tjeffree/lumberelite/README.md

# lumberelite

Based off of the brilliant work of [Peej's Lumberjack](https://github.com/peej/lumberjack-keyboard).

An Elite-C version of the Lumberjack with the addition of an OLED screen.

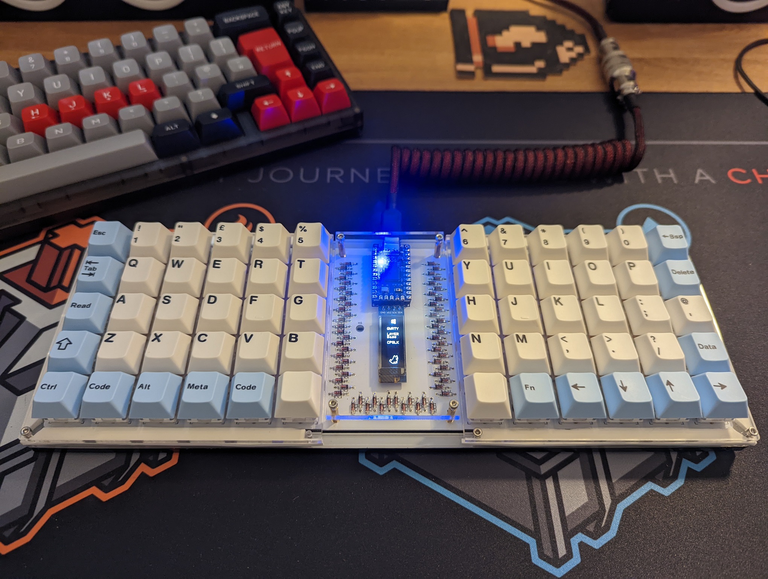
[picture p1: images/le_1.jpg]

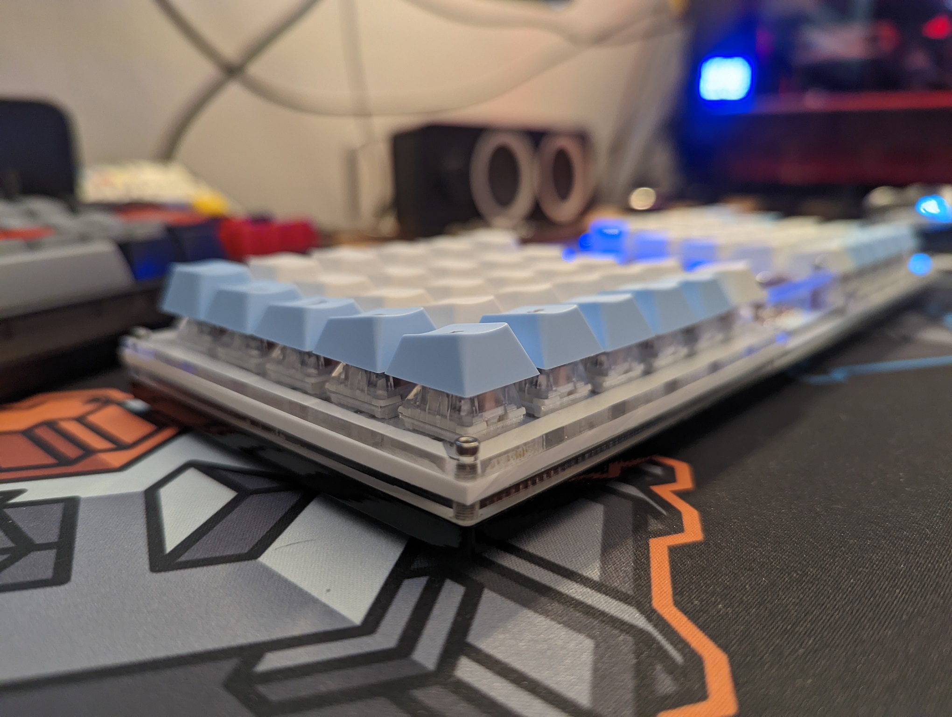
[picture p2: images/le_2.jpg]

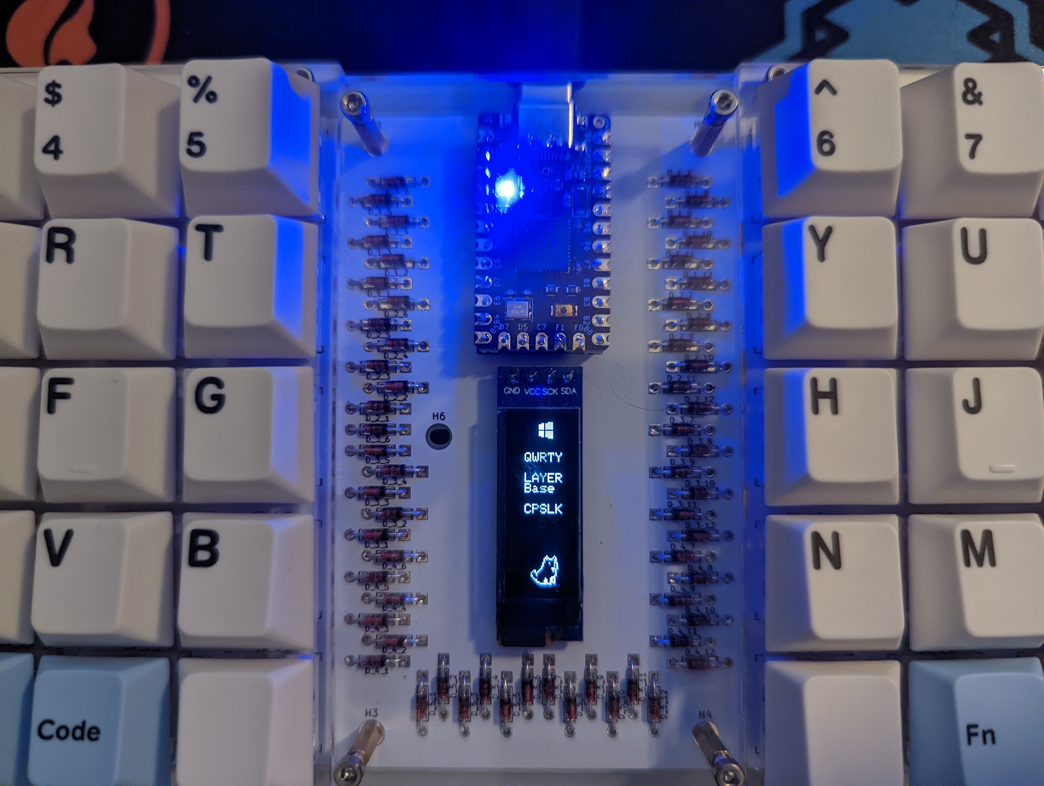
[picture p3: images/le_3.jpg]

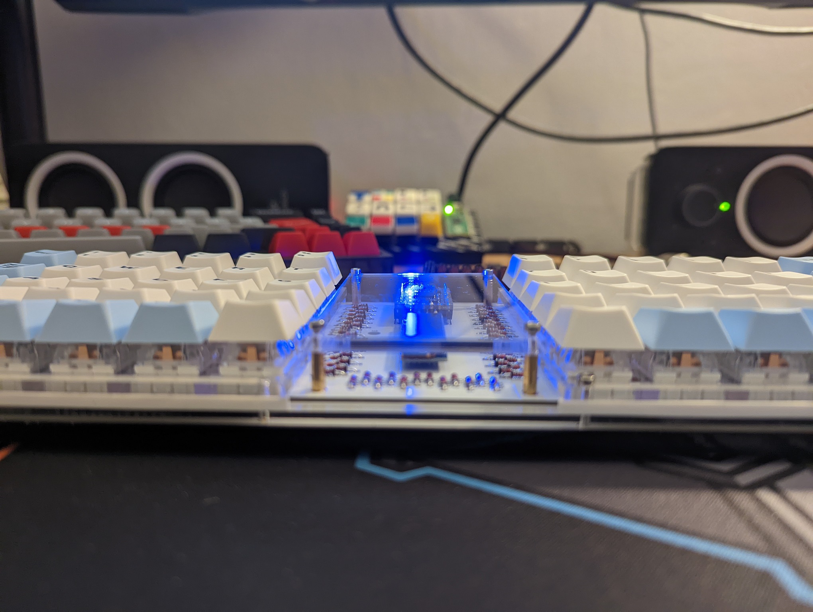
[picture p4: images/le_4.jpg]
