tjeffree/lumberelite/dxf/lumberjack-split v18 - Bottom.dxf

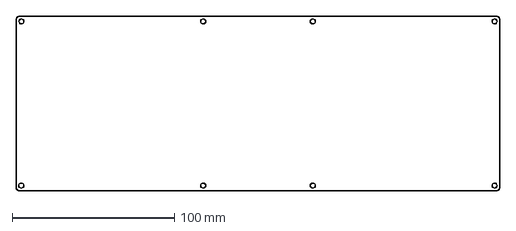
[picture p5: CAD file, 2022-02-27]
dxf/lumberjack-split v18 - Bottom.dxf
297.8 x 107.4 mm
