tjeffree/lumberelite/dxf/lumberjack-split v18 - Center.dxf

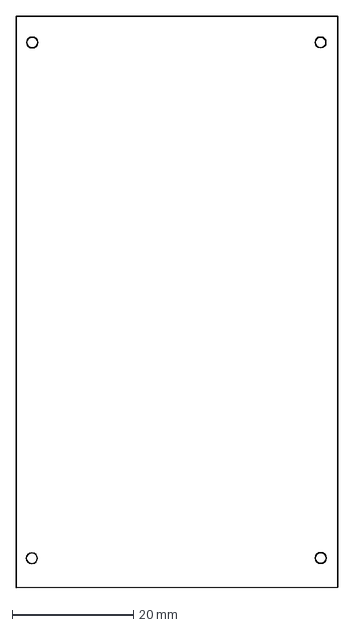
[picture p6: CAD file, 2022-02-27]
dxf/lumberjack-split v18 - Center.dxf
53.1 x 94.3 mm
