tjeffree/lumberelite/dxf/lumberjack-split v18 - Mid.dxf

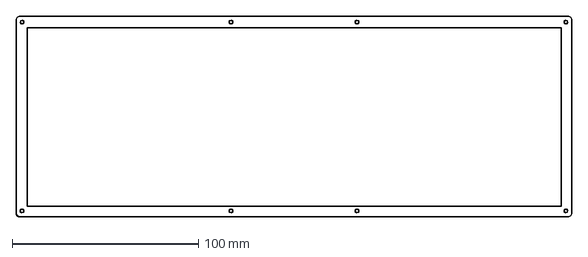
[picture p7: CAD file, 2022-02-27]
dxf/lumberjack-split v18 - Mid.dxf
297.8 x 107.4 mm
