tjeffree/lumberelite/dxf/lumberjack-split v18 - Top.dxf

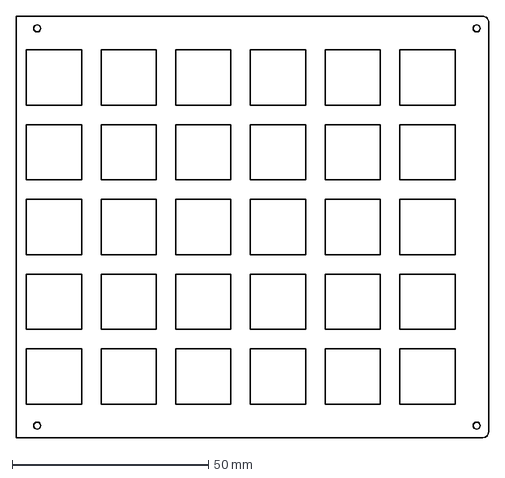
[picture p8: CAD file, 2022-02-27]
dxf/lumberjack-split v18 - Top.dxf
120.5 x 107.4 mm
