tjeffree/lumberelite/lumberelite.kicad_pcb

## KiCad design lumberelite.kicad_pcb (2022-02-27)

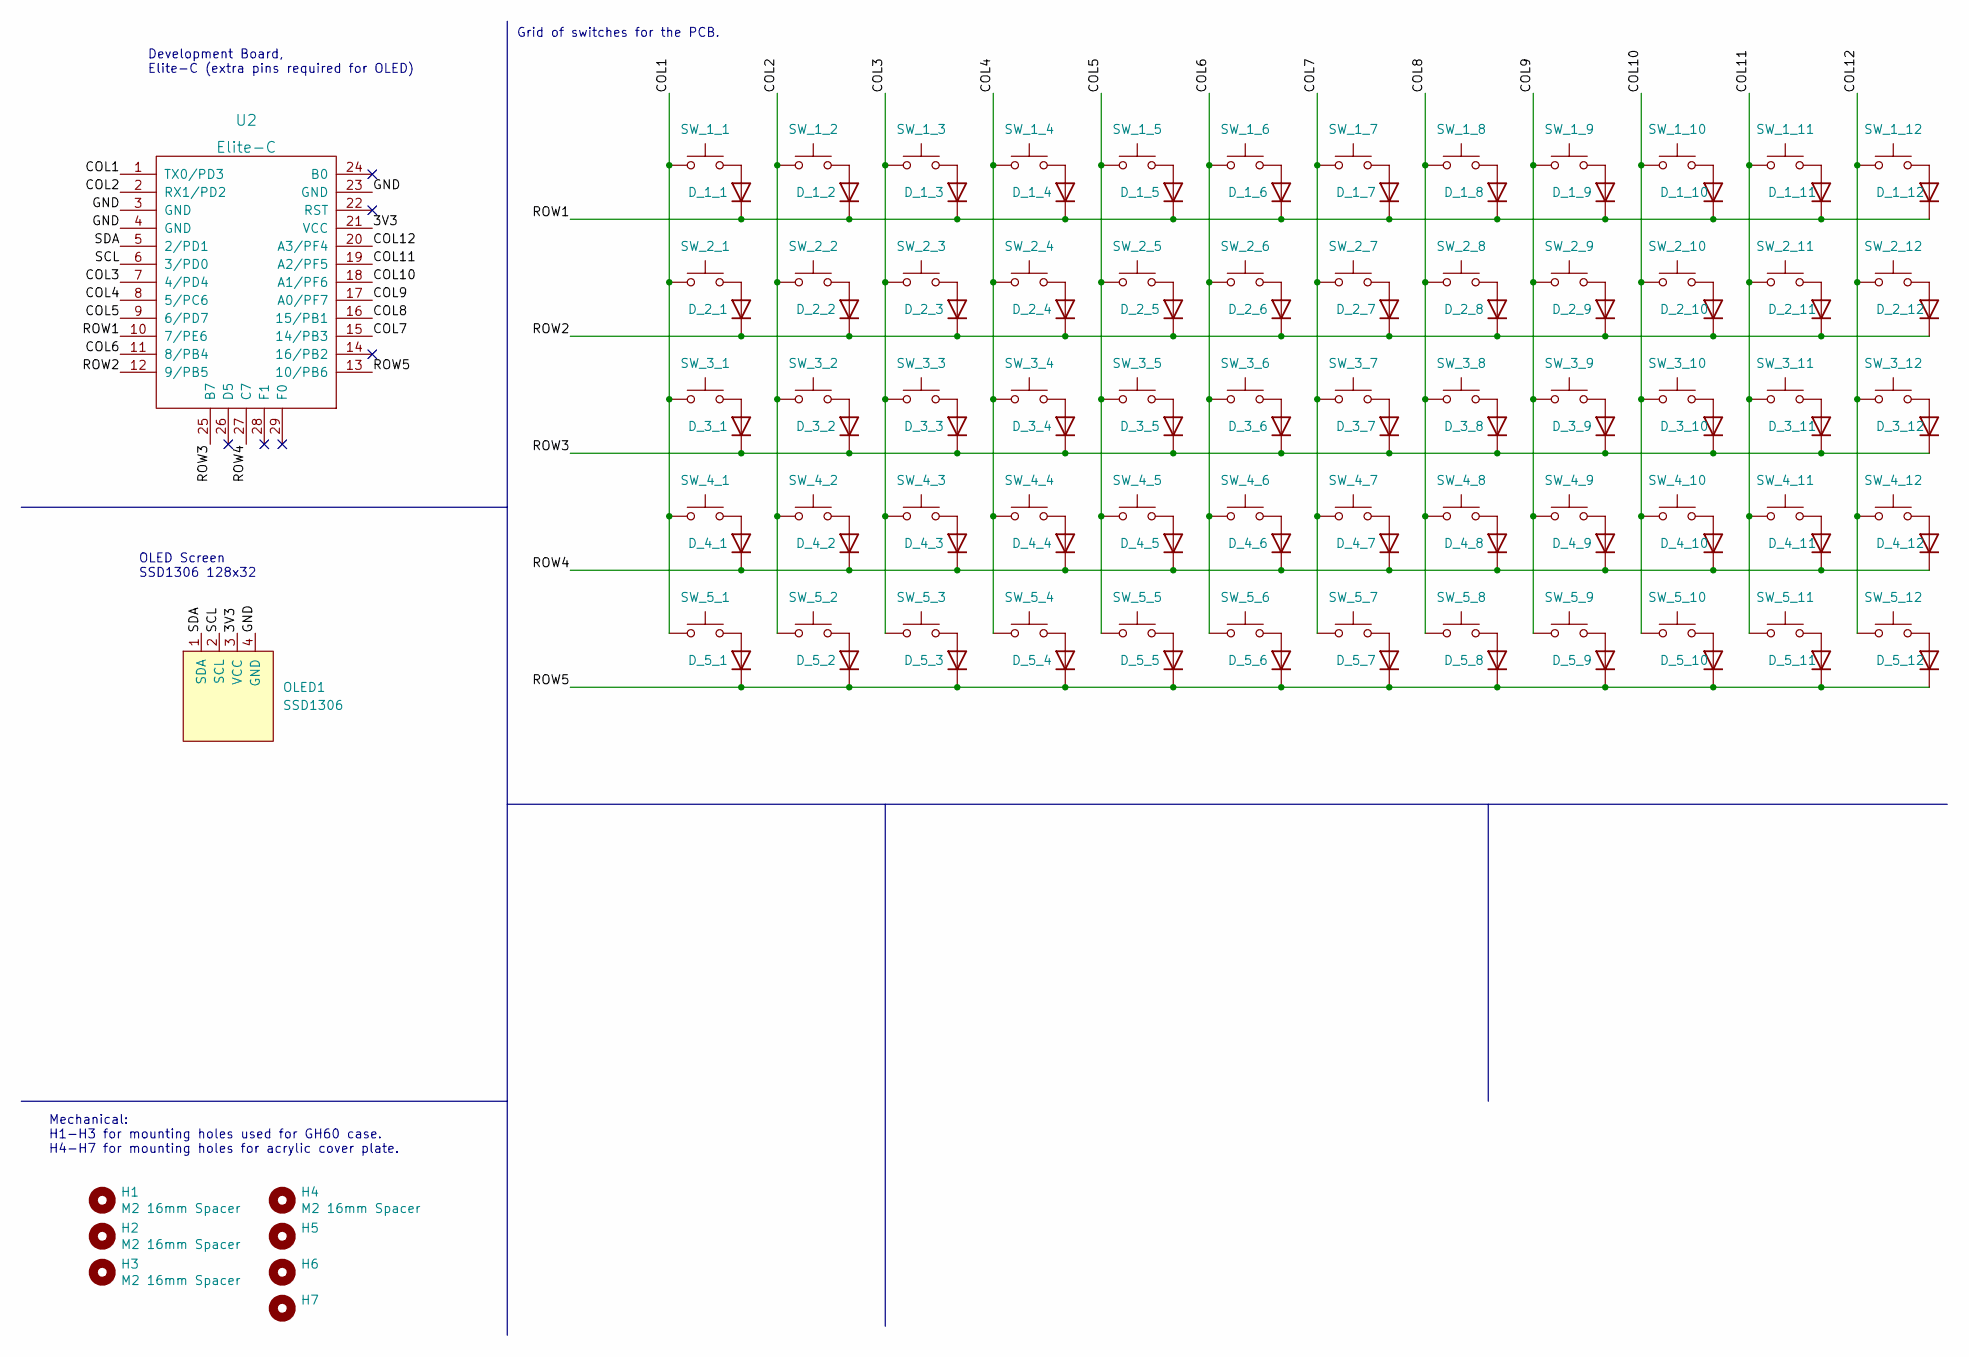
[picture p9: schematic lumberelite.kicad_sch, T-1: Lumberelite]

Parts:
D_1_1, D_1_2, D_1_3, D_1_4, D_1_5, D_1_6, D_1_7, D_1_8, D_1_9, D_1_10, D_1_11, D_1_12, D_2_1, D_2_2, D_2_3, D_2_4, D_2_5, D_2_6, D_2_7, D_2_8, D_2_9, D_2_10, D_2_11, D_2_12, D_3_1, D_3_2, D_3_3, D_3_4, D_3_5, D_3_6, D_3_7, D_3_8, D_3_9, D_3_10, D_3_11, D_3_12, D_4_1, D_4_2, D_4_3, D_4_4, D_4_5, D_4_6, D_4_7, D_4_8, D_4_9, D_4_10, D_4_11, D_4_12, D_5_1, D_5_2, D_5_3, D_5_4, D_5_5, D_5_6, D_5_7, D_5_8, D_5_9, D_5_10, D_5_11, D_5_12: 1N4148; Diode-dual
H1, H2, H3, H4: M2 16mm Spacer; MountingHole_2.2mm_M2_DIN965_Pad
H5: Bumpon_3M_F0502
H6, H7: MountingHole_2.2mm_M2_elongated
OLED1: SSD1306; OLED_v2
SW_1_1, SW_1_2, SW_1_3, SW_1_4, SW_1_5, SW_1_6, SW_1_7, SW_1_8, SW_1_9, SW_1_10, SW_1_11, SW_1_12, SW_2_1, SW_2_2, SW_2_3, SW_2_4, SW_2_5, SW_2_6, SW_2_7, SW_2_8, SW_2_9, SW_2_10, SW_2_11, SW_2_12, SW_3_1, SW_3_2, SW_3_3, SW_3_4, SW_3_5, SW_3_6, SW_3_7, SW_3_8, SW_3_9, SW_3_10, SW_3_11, SW_3_12, SW_4_1, SW_4_2, SW_4_3, SW_4_4, SW_4_5, SW_4_6, SW_4_7, SW_4_8, SW_4_9, SW_4_10, SW_4_11, SW_4_12, SW_5_1, SW_5_2, SW_5_3, SW_5_4, SW_5_5, SW_5_6, SW_5_7, SW_5_8, SW_5_9, SW_5_10, SW_5_11, SW_5_12: MX-compatible or Kailh Choc v1; SW_MX_PG1350_NoLed
U2: Elite-C; Elite-C-ZigZag

Connections:
/3V3: OLED1.3 (VCC), U2.21 (VCC)
/COL1: SW_1_1.1, SW_2_1.1, SW_3_1.1, SW_4_1.1, SW_5_1.1, U2.1 (TX0/PD3)
/COL2: SW_1_2.1, SW_2_2.1, SW_3_2.1, SW_4_2.1, SW_5_2.1, U2.2 (RX1/PD2)
/COL3: SW_1_3.1, SW_2_3.1, SW_3_3.1, SW_4_3.1, SW_5_3.1, U2.7 (4/PD4)
/COL4: SW_1_4.1, SW_2_4.1, SW_3_4.1, SW_4_4.1, SW_5_4.1, U2.8 (5/PC6)
/COL5: SW_1_5.1, SW_2_5.1, SW_3_5.1, SW_4_5.1, SW_5_5.1, U2.9 (6/PD7)
/COL6: SW_1_6.1, SW_2_6.1, SW_3_6.1, SW_4_6.1, SW_5_6.1, U2.11 (8/PB4)
/COL7: SW_1_7.1, SW_2_7.1, SW_3_7.1, SW_4_7.1, SW_5_7.1, U2.15 (14/PB3)
/COL8: SW_1_8.1, SW_2_8.1, SW_3_8.1, SW_4_8.1, SW_5_8.1, U2.16 (15/PB1)
/COL9: SW_1_9.1, SW_2_9.1, SW_3_9.1, SW_4_9.1, SW_5_9.1, U2.17 (A0/PF7)
/COL10: SW_1_10.1, SW_2_10.1, SW_3_10.1, SW_4_10.1, SW_5_10.1, U2.18 (A1/PF6)
/COL11: SW_1_11.1, SW_2_11.1, SW_3_11.1, SW_4_11.1, SW_5_11.1, U2.19 (A2/PF5)
/COL12: SW_1_12.1, SW_2_12.1, SW_3_12.1, SW_4_12.1, SW_5_12.1, U2.20 (A3/PF4)
/GND: OLED1.4 (GND), U2.3 (GND), U2.4 (GND), U2.23 (GND)
/ROW1: D_1_1.1 (K), D_1_2.1 (K), D_1_3.1 (K), D_1_4.1 (K), D_1_5.1 (K), D_1_6.1 (K), D_1_7.1 (K), D_1_8.1 (K), D_1_9.1 (K), D_1_10.1 (K), D_1_11.1 (K), D_1_12.1 (K), U2.10 (7/PE6)
/ROW2: D_2_1.1 (K), D_2_2.1 (K), D_2_3.1 (K), D_2_4.1 (K), D_2_5.1 (K), D_2_6.1 (K), D_2_7.1 (K), D_2_8.1 (K), D_2_9.1 (K), D_2_10.1 (K), D_2_11.1 (K), D_2_12.1 (K), U2.12 (9/PB5)
/ROW3: D_3_1.1 (K), D_3_2.1 (K), D_3_3.1 (K), D_3_4.1 (K), D_3_5.1 (K), D_3_6.1 (K), D_3_7.1 (K), D_3_8.1 (K), D_3_9.1 (K), D_3_10.1 (K), D_3_11.1 (K), D_3_12.1 (K), U2.25 (B7)
/ROW4: D_4_1.1 (K), D_4_2.1 (K), D_4_3.1 (K), D_4_4.1 (K), D_4_5.1 (K), D_4_6.1 (K), D_4_7.1 (K), D_4_8.1 (K), D_4_9.1 (K), D_4_10.1 (K), D_4_11.1 (K), D_4_12.1 (K), U2.27 (C7)
/ROW5: D_5_1.1 (K), D_5_2.1 (K), D_5_3.1 (K), D_5_4.1 (K), D_5_5.1 (K), D_5_6.1 (K), D_5_7.1 (K), D_5_8.1 (K), D_5_9.1 (K), D_5_10.1 (K), D_5_11.1 (K), D_5_12.1 (K), U2.13 (10/PB6)
/SCL: OLED1.2 (SCL), U2.6 (3/PD0)
/SDA: OLED1.1 (SDA), U2.5 (2/PD1)
unnamed: D_1_1.2 (A), SW_1_1.2
unnamed: D_1_2.2 (A), SW_1_2.2
unnamed: D_1_3.2 (A), SW_1_3.2
unnamed: D_1_4.2 (A), SW_1_4.2
unnamed: D_1_5.2 (A), SW_1_5.2
unnamed: D_1_6.2 (A), SW_1_6.2
unnamed: D_1_7.2 (A), SW_1_7.2
unnamed: D_1_8.2 (A), SW_1_8.2
unnamed: D_1_9.2 (A), SW_1_9.2
unnamed: D_1_10.2 (A), SW_1_10.2
unnamed: D_1_11.2 (A), SW_1_11.2
unnamed: D_1_12.2 (A), SW_1_12.2
unnamed: D_2_1.2 (A), SW_2_1.2
unnamed: D_2_2.2 (A), SW_2_2.2
unnamed: D_2_3.2 (A), SW_2_3.2
unnamed: D_2_4.2 (A), SW_2_4.2
unnamed: D_2_5.2 (A), SW_2_5.2
unnamed: D_2_6.2 (A), SW_2_6.2
unnamed: D_2_7.2 (A), SW_2_7.2
unnamed: D_2_8.2 (A), SW_2_8.2
unnamed: D_2_9.2 (A), SW_2_9.2
unnamed: D_2_10.2 (A), SW_2_10.2
unnamed: D_2_11.2 (A), SW_2_11.2
unnamed: D_2_12.2 (A), SW_2_12.2
unnamed: D_3_1.2 (A), SW_3_1.2
unnamed: D_3_2.2 (A), SW_3_2.2
unnamed: D_3_3.2 (A), SW_3_3.2
unnamed: D_3_4.2 (A), SW_3_4.2
unnamed: D_3_5.2 (A), SW_3_5.2
unnamed: D_3_6.2 (A), SW_3_6.2
unnamed: D_3_7.2 (A), SW_3_7.2
unnamed: D_3_8.2 (A), SW_3_8.2
unnamed: D_3_9.2 (A), SW_3_9.2
unnamed: D_3_10.2 (A), SW_3_10.2
unnamed: D_3_11.2 (A), SW_3_11.2
unnamed: D_3_12.2 (A), SW_3_12.2
unnamed: D_4_1.2 (A), SW_4_1.2
unnamed: D_4_2.2 (A), SW_4_2.2
unnamed: D_4_3.2 (A), SW_4_3.2
unnamed: D_4_4.2 (A), SW_4_4.2
unnamed: D_4_5.2 (A), SW_4_5.2
unnamed: D_4_6.2 (A), SW_4_6.2
unnamed: D_4_7.2 (A), SW_4_7.2
unnamed: D_4_8.2 (A), SW_4_8.2
unnamed: D_4_9.2 (A), SW_4_9.2
unnamed: D_4_10.2 (A), SW_4_10.2
unnamed: D_4_11.2 (A), SW_4_11.2
unnamed: D_4_12.2 (A), SW_4_12.2
unnamed: D_5_1.2 (A), SW_5_1.2
unnamed: D_5_2.2 (A), SW_5_2.2
unnamed: D_5_3.2 (A), SW_5_3.2
unnamed: D_5_4.2 (A), SW_5_4.2
unnamed: D_5_5.2 (A), SW_5_5.2
unnamed: D_5_6.2 (A), SW_5_6.2
unnamed: D_5_7.2 (A), SW_5_7.2
unnamed: D_5_8.2 (A), SW_5_8.2
unnamed: D_5_9.2 (A), SW_5_9.2
unnamed: D_5_10.2 (A), SW_5_10.2
unnamed: D_5_11.2 (A), SW_5_11.2
unnamed: D_5_12.2 (A), SW_5_12.2

Notes on the sheet:
Grid of switches for the PCB.
OLED Screen SSD1306 128x32
Development Board, Elite-C (extra pins required for OLED)
Mechanical: H1-H3 for mounting holes used for GH60 case. H4-H7 for mounting holes for acrylic cover plate.

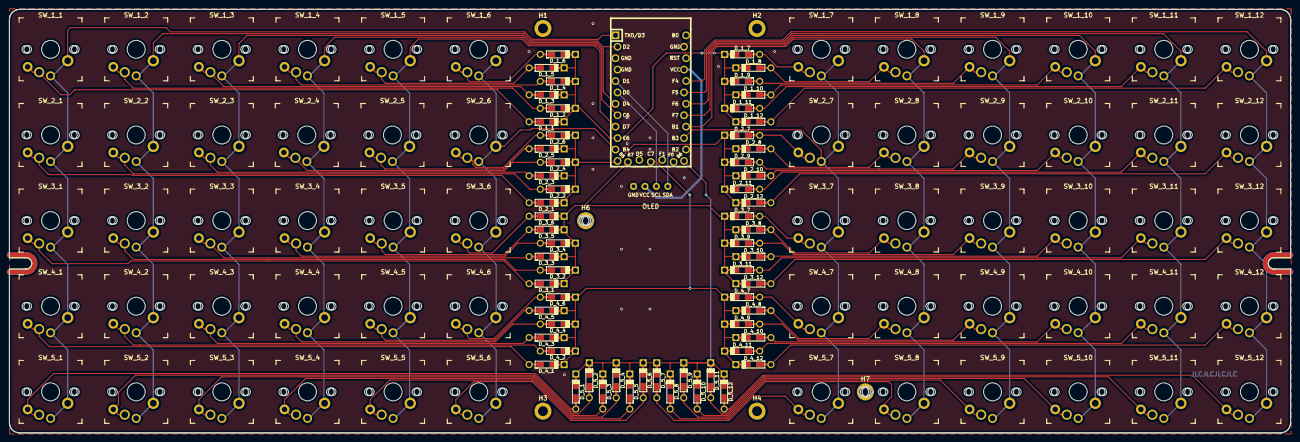
[picture p10: board lumberelite.kicad_pcb from above]

Board: 2 copper layers, 285.0 x 94.2 mm, 131 parts (0 on the bottom side), 81 nets.

Other parts of the board:
HOLE: Graphic_Mask_HalfHole
HOLE#2: Graphic_Mask_HalfHole
