tjeffree/lumberelite/qmk/lumberelite/config.h

#ifndef CONFIG_H
#define CONFIG_H

#include "config_common.h"

/* USB Device descriptor parameter */
#define VENDOR_ID       0x0a7e
#define PRODUCT_ID      0x0a7f
#define DEVICE_VER      0x0001
#define MANUFACTURER    tjeffree
#define PRODUCT         lumberelite

/* key matrix size */
#define MATRIX_ROWS 5
#define MATRIX_COLS 12

/* key matrix pins */
#define MATRIX_ROW_PINS { E6, B5, B7, C7, B6 }
#define MATRIX_COL_PINS { D3, D2, D4, C6, D7, B4, B3, B1, F7, F6, F5, F4 }
#define UNUSED_PINS

/* COL2ROW or ROW2COL */
#define DIODE_DIRECTION COL2ROW

/* number of backlight levels */

#ifdef BACKLIGHT_PIN
#define BACKLIGHT_LEVELS 0
#endif

/* Mechanical locking support. Use KC_LCAP, KC_LNUM or KC_LSCR instead in keymap */
#define LOCKING_SUPPORT_ENABLE

/* Locking resynchronize hack */
#define LOCKING_RESYNC_ENABLE

/* key combination for command */
#define IS_COMMAND() ( \
    keyboard_report->mods == (MOD_BIT(KC_LSHIFT) | MOD_BIT(KC_RSHIFT)) \
)

#define OLED_TIMEOUT 120000
#define OLED_BRIGHTNESS 120

#ifdef RGB_DI_PIN
#define RGBLIGHT_ANIMATIONS
#define RGBLED_NUM 0
#define RGBLIGHT_HUE_STEP 8
#define RGBLIGHT_SAT_STEP 8
#define RGBLIGHT_VAL_STEP 8
#endif

#endif
